AndreiVladescu/Reverse-Engineering-Laser-Rangefinder/README.md

# Reverse-Engineering-Laser-Rangefinder
Guide on reverse engineering a laser rangefinder and then reusing it.
