AndreiVladescu/Reverse-Engineering-Laser-Rangefinder/(commit log)

2024-08-03 Added UART captures
2024-08-05 Added measurement files
    [0.352m.csv, 0.394m.csv, 0.826m.csv, 1.111m.csv, 1.844m.csv]
2024-08-07 Moved arduino program
